Jiu-xiao/XRDAP-SWD-Probe/(commit log)

2025-11-18 Fix README typo and clean VCD helpers
    [vcd_to_png.py]
2025-11-18 更新网表与工程
